QATCH-Technologies/openQCM-PCB/README.md

# openQCM-PCB
KiCad project of the QATCH openQCM main circuit PCB (requires Teensy 4.1)
