QATCH-Technologies/openQCM-PCB/QATCH openQCM PCB.kicad_pcb

## KiCad design QATCH openQCM PCB.kicad_pcb (2025-04-10)

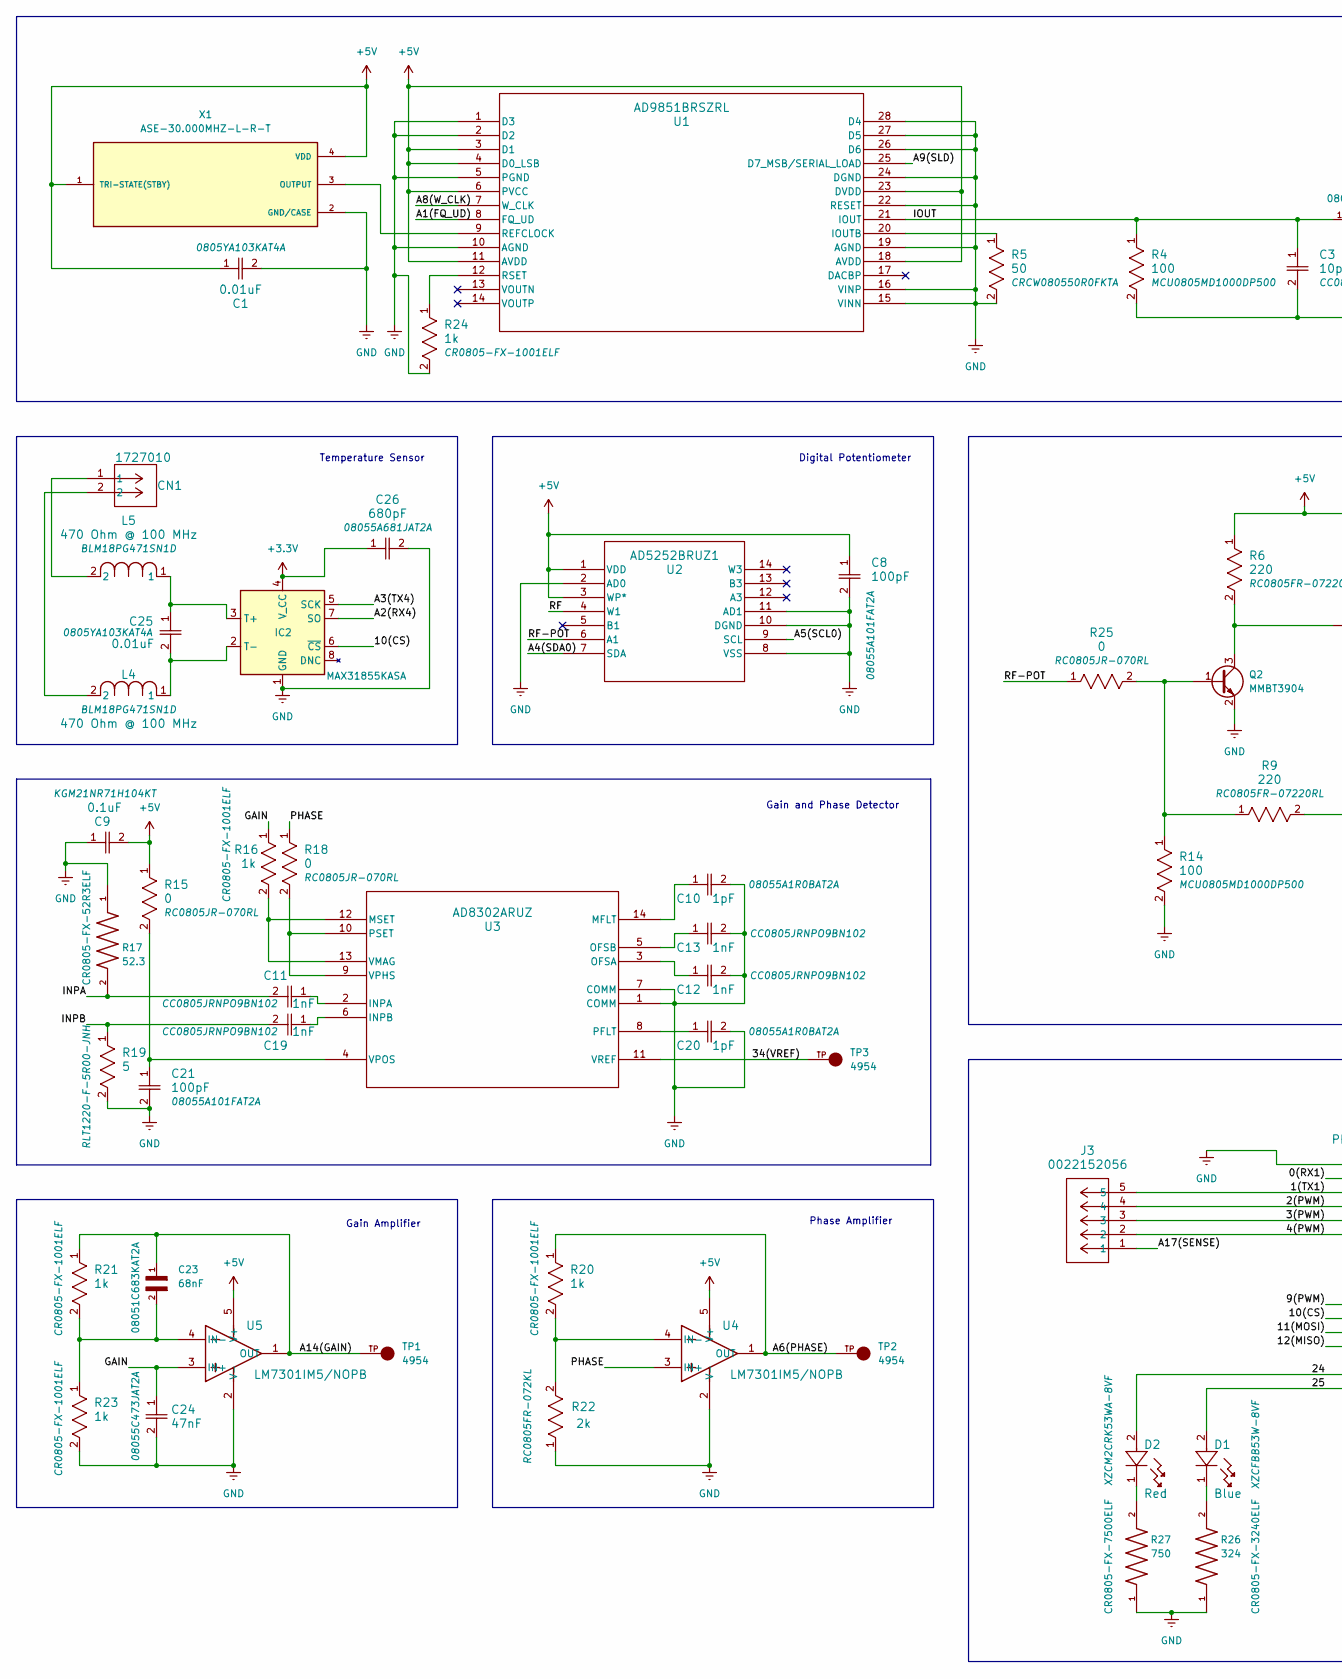
[picture p1: schematic QATCH openQCM PCB.kicad_sch, part in row 1, column 1]

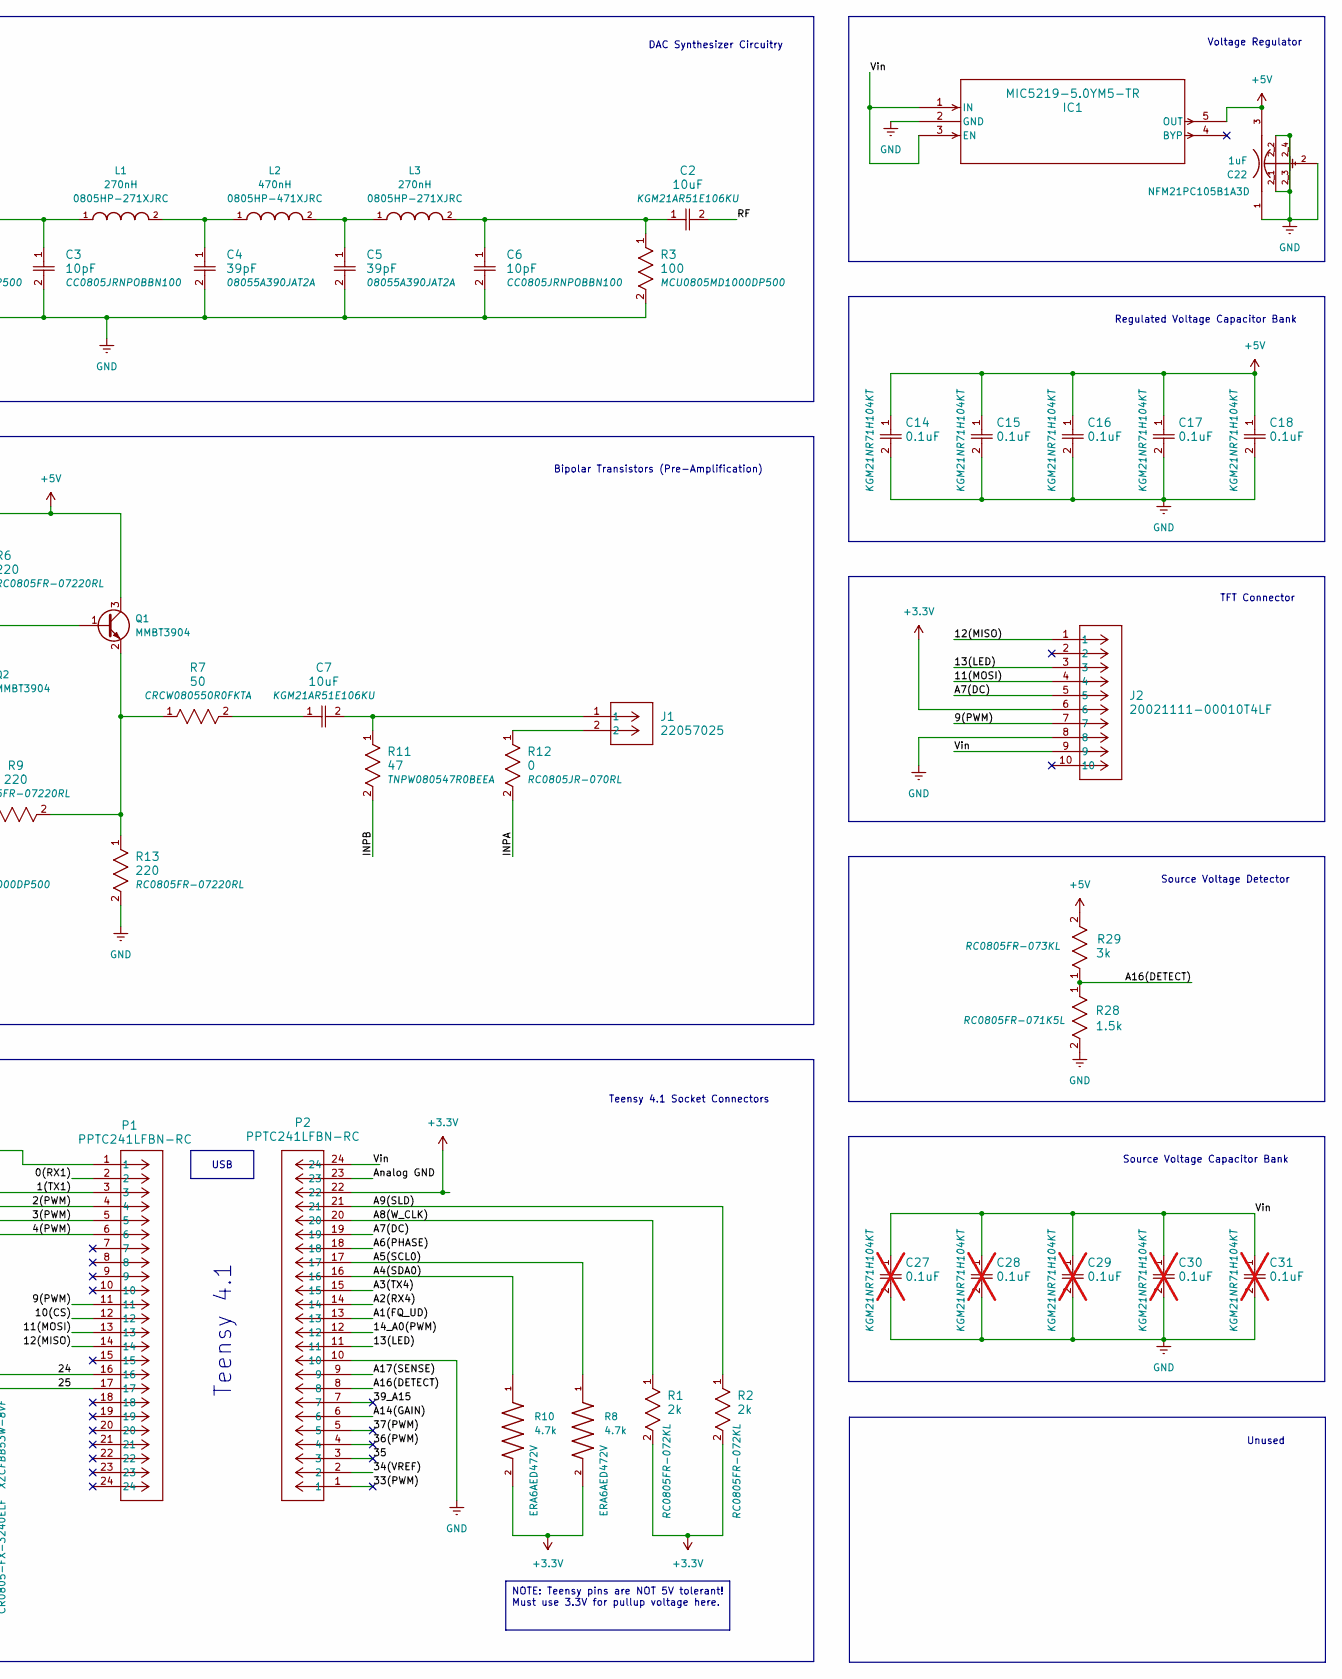
[picture p2: schematic QATCH openQCM PCB.kicad_sch, part in row 1, column 2]

Parts:
C1, C25: 0.01uF; CAP_08051A0R8CAT2A_AVX
C2, C7: 10uF; CAP_KGM21_KAV
C3, C6: 10pF; CAP_CC0805_YAG
C4, C5: 39pF; CAP_0805J_AVX
C8, C21: 100pF; CAP_0805J_AVX
C9, C14, C15, C16, C17, C18: 0.1uF; CAP_KGM21_KAV
C10, C20: 1pF; CAP_0805J_AVX
C11, C12, C13, C19: 1nF; CAP_CC0805_YAG
C22: 1uF; FIL_NFM21PC105B1A3D; PARTREV N/A
C23: 68nF; CAPC2012X140N
C24: 47nF; 0805_AVX
C26: 680pF; CAP_0805J_AVX
C27, C28, C29, C30, C31: 0.1uF; CAP_KGM21_KAV; not fitted
CN1: 1727010; CONN_1727010
D1: Blue; LED_SMD_XZCM_1P6X0P8_SLD
D2: Red; LED_SMD_XZCM_1P6X0P8_SLD
IC1: MIC5219-5.0YM5-TR; SOT-23-5_M5_MCH
IC2: MAX31855KASA; SOIC-8_3.9x4.9mm_P1.27mm
J1: 22057025; CON_22057025_MOL
J2: 20021111-00010T4LF; CONN_MINITEK_2X5_HDR
J3: 0022152056; CON_22152056_MOL
L1, L3: 270nH; INDC2015X152N
L2: 470nH; INDC2015X152N
L4, L5: 470 Ohm @ 100 MHz; IND_BLM18_0603_MUR
P1, P2: PPTC241LFBN-RC; CONN24_PPTC241LFBN-RC_SUL
Q1, Q2: MMBT3904; SOT-23
R1, R2, R22: 2k; RC0805N_YAG
R3, R4, R14: 100; MCU0805-AT_VIS
R5, R7: 50; RES_RC0805_YAG
R6, R9, R13: 220; RES_RC0805_YAG
R8, R10: 4.7k; RES_ERA6AED472V; PARTREV 3/1/2020
R11: 47; RES_TNPW0805_VIS
R12, R15, R18, R25: 0; RC0805N_YAG
R16, R20, R21, R23, R24: 1k; BO_CR0805
R17: 52.3; RESC2012X60N; DigiKey_Part_Number 118-CR0805-FX-52R3ELFTR-ND
R19: 5; RES_ERA6AED472V
R26: 324; RESC2012X60N
R27: 750; RESC2012X60N
R28: 1.5k; RC0805N_YAG
R29: 3k; RC0805N_YAG
TP1, TP2, TP3: 4954; KEYSTONE_4954; PARTREV B
U1: AD9851BRSZRL; RS_28_ADI
U2: AD5252BRUZ1; RU_14_ADI
U3: AD8302ARUZ; RU_14_ADI
U4, U5: LM7301IM5/NOPB; SOT95P280X145-5N
X1: ASE-30.000MHZ-L-R-T; XTAL_ASE-30.000MHZ-L-R-T; PARTREV 02-18-22

Connections:
+3.3V: C26.1, IC2.4 (V_CC), J2.6, P2.22, R1.2, R2.2, R8.2, R10.2
+5V: C1.1, C8.1, C9.2, C14.1, C15.1, C16.1, C17.1, C18.1, C22.3, IC1.5 (OUT), Q1.3 (C), R6.1, R15.1, R29.2, U1.3 (D1), U1.4 (D0_LSB), U1.6 (PVCC), U1.11 (AVDD), U1.18 (AVDD), U1.23 (DVDD), U2.1 (VDD), U2.3 (WP*), U4.5 (V+), U5.5 (V+), X1.1 (TRI-STATE(STBY)), X1.4 (VDD)
/0(RX1): P1.2
/1(TX1): J3.5, P1.3
/2(PWM): J3.4, P1.4
/3(PWM): J3.3, P1.5
/4(PWM): J3.2, P1.6
/9(PWM): J2.7, P1.11
/10(CS): IC2.6 (~CS), P1.12
/11(MOSI): J2.4, P1.13
/12(MISO): J2.1, P1.14
/13(LED): J2.3, P2.11
/14_A0(PWM): P2.12
/24: D2.2, P1.16
/25: D1.2, P1.17
/33(PWM): P2.1
/34(VREF): P2.2, TP3.TP, U3.11 (VREF)
/35: P2.3
/36(PWM): P2.4
/37(PWM): P2.5
/39_A15: P2.7
/A1(FQ_UD): P2.13, U1.8 (FQ_UD)
/A2(RX4): IC2.7 (SO), P2.14
/A3(TX4): IC2.5 (SCK), P2.15
/A4(SDA0): P2.16, R10.1, U2.7 (SDA)
/A5(SCL0): P2.17, R8.1, U2.9 (SCL)
/A6(PHASE): P2.18, R20.1, TP2.TP, U4.1 (OUT)
/A7(DC): J2.5, P2.19
/A8(W_CLK): P2.20, R1.1, U1.7 (W_CLK)
/A9(SLD): P2.21, R2.1, U1.25 (D7_MSB/SERIAL_LOAD)
/A14(GAIN): C23.1, P2.6, R21.1, TP1.TP, U5.1 (OUT)
/A16(DETECT): P2.8, R28.1, R29.1
/A17(SENSE): J3.1, P2.9
/Analog GND: P2.23
/GAIN: C24.1, R16.1, U5.3 (IN+)
/INPA: C11.2, R12.2, R17.2
/INPB: C19.2, R11.2, R19.1
/IOUT: C3.1, L1.1, R4.1, U1.21 (IOUT)
/PHASE: R18.1, U4.3 (IN+)
/RF: C2.2, U2.4 (W1)
/RF-POT: R25.1, U2.6 (A1)
/Vin: C27.1, C28.1, C29.1, C30.1, C31.1, IC1.1 (IN), IC1.3 (EN), J2.9, P2.24
GND: C1.2, C3.2, C4.2, C5.2, C6.2, C8.2, C9.1, C10.2, C12.2, C13.2, C14.2, C15.2, C16.2, C17.2, C18.2, C20.2, C21.2, C22.1, C22.2, C22.2_1, C22.2_2, C22.2_3, C22.2_4, C24.2, C26.2, C27.2, C28.2, C29.2, C30.2, C31.2, IC1.2 (GND), IC2.1 (GND), J2.8, P1.1, P2.10, Q2.2 (E), R3.2, R4.2, R5.2, R13.2, R14.2, R17.1, R19.2, R22.1, R23.2, R24.2, R26.1, R27.1, R28.2, U1.1 (D3), U1.2 (D2), U1.5 (PGND), U1.10 (AGND), U1.15 (VINN), U1.16 (VINP), U1.19 (AGND), U1.22 (RESET), U1.24 (DGND), U1.26 (D6), U1.27 (D5), U1.28 (D4), U2.2 (AD0), U2.8 (VSS), U2.10 (DGND), U2.11 (AD1), U3.1 (COMM), U3.7 (COMM), U4.2 (V-), U5.2 (V-), X1.2 (GND/CASE)
unnamed: C2.1, C6.1, L3.2, R3.1
unnamed: C4.1, L1.2, L2.1
unnamed: C5.1, L2.2, L3.1
unnamed: C7.1, R7.2
unnamed: C7.2, J1.1, R11.1
unnamed: CN1.1, L5.2
unnamed: CN1.2, L4.2
unnamed: D1.1, R26.2
unnamed: D2.1, R27.2
unnamed: C25.1, IC2.3 (T+), L5.1
unnamed: C25.2, IC2.2 (T-), L4.1
unnamed: J1.2, R12.1
unnamed: Q1.1 (B), Q2.3 (C), R6.2
unnamed: Q1.2 (E), R7.1, R9.2, R13.1
unnamed: Q2.1 (B), R9.1, R14.1, R25.2
unnamed: R5.1, U1.20 (IOUTB)
unnamed: U1.9 (REFCLOCK), X1.3 (OUTPUT)
unnamed: R24.1, U1.12 (RSET)
unnamed: C11.1, U3.2 (INPA)
unnamed: C19.1, U3.6 (INPB)
unnamed: C10.1, U3.14 (MFLT)
unnamed: R16.2, U3.12 (MSET), U3.13 (VMAG)
unnamed: C12.1, U3.3 (OFSA)
unnamed: C13.1, U3.5 (OFSB)
unnamed: C20.1, U3.8 (PFLT)
unnamed: R18.2, U3.9 (VPHS), U3.10 (PSET)
unnamed: C21.1, R15.2, U3.4 (VPOS)
unnamed: R20.2, R22.2, U4.4 (IN-)
unnamed: C23.2, R21.2, R23.1, U5.4 (IN-)

Notes on the sheet:
USB
NOTE: Teensy pins are NOT 5V tolerant! Must use 3.3V for pullup voltage here.
Source Voltage Capacitor Bank
Digital Potentiometer
Phase Amplifier
Gain and Phase Detector
Voltage Regulator
Gain Amplifier
Teensy 4.1 Socket Connectors
TFT Connector
Source Voltage Detector
Temperature Sensor
Teensy 4.1
Bipolar Transistors (Pre-Amplification)
Regulated Voltage Capacitor Bank
Unused
DAC Synthesizer Circuitry

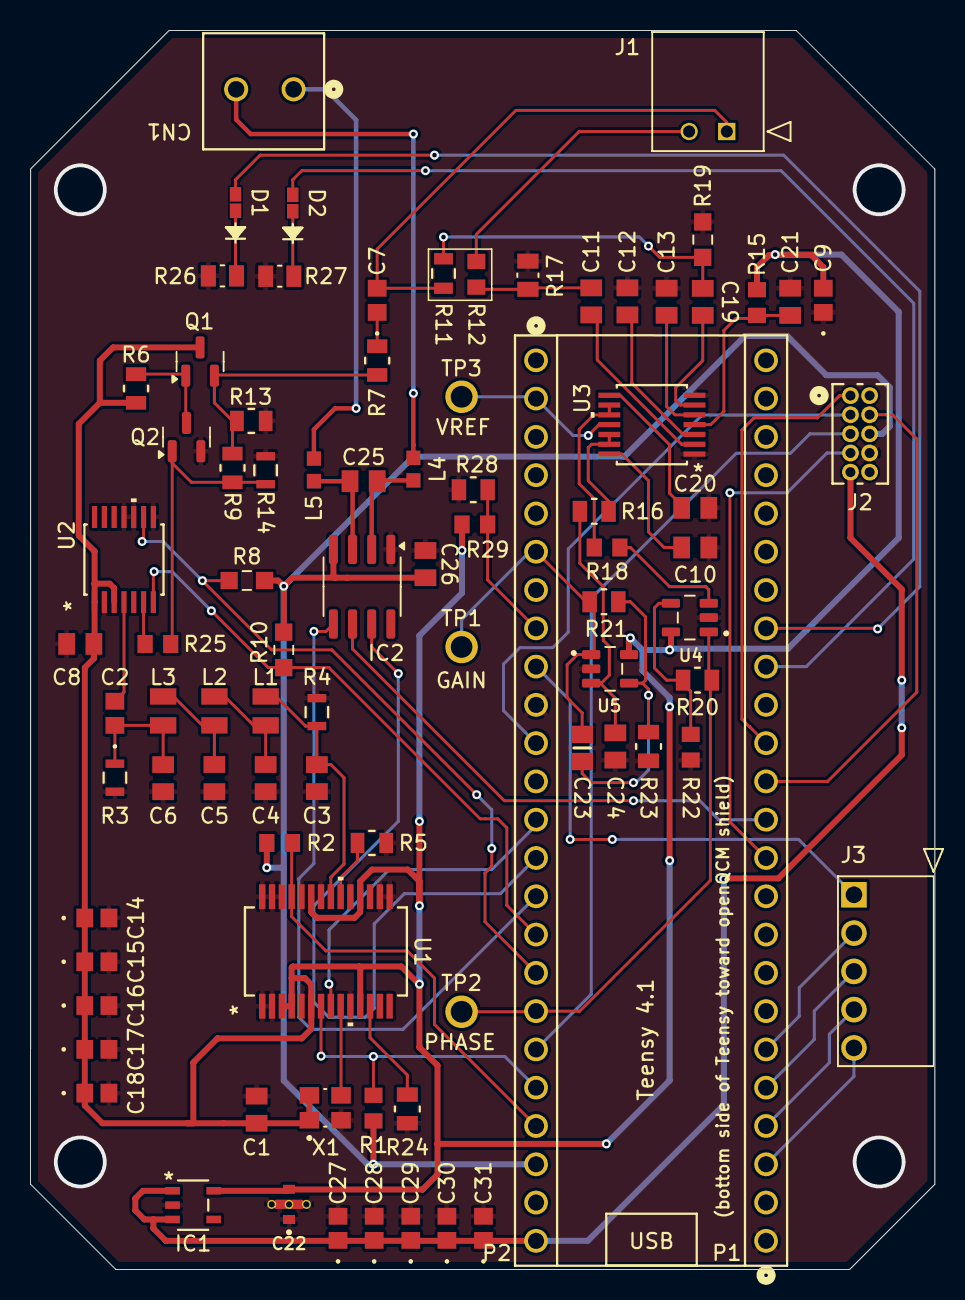
[picture p3: board QATCH openQCM PCB.kicad_pcb from above]

Board: 2 copper layers, 60.0 x 82.2 mm, 86 parts (0 on the bottom side), 64 nets.
