QATCH-Technologies/openQCM-PCB/(commit log)

2024-05-16 Initial commit of KiCad project to GitHub
    [QATCH openQCM PCB.kicad_pcb, QATCH openQCM PCB.kicad_sch]
2024-05-21 Allow BOM files in repo
2025-04-10 Committing local changes, adding cap bank and fix 5V pullups
    [QATCH openQCM PCB.kicad_pcb, QATCH openQCM PCB.kicad_sch]
